garou-g/kicad-library/CHANGELOG.md

# Changelog
kicad-library changelog

## [Unreleased]
