garou-g/kicad-library/(commit log)

2019-11-25 Added Bus_PCI_Express_x1 connector
2019-12-11 USB-TYPE-C connector footprint
2020-01-17 Add n-mosfet SiSC06DN
2020-01-17 add p-mosfet SiSH101DN
2020-01-19 add TE_640456 connectors
2020-01-20 Added interactive bom plugin link to README
2020-01-24 Added TE_640456 connectors 3D model
2020-01-24 Changed BQ24090DGQ and added it footprint Texas_S-PDSO-G10_EP2x3mm_ThermalVias
2020-02-20 Added footprints for bluetooth antenna and noname vibromotor
2020-03-05 LED 3737_OSRAM, SMD 3528 patterns
2020-03-22 Changed bluetooth antenna footprint
2020-06-03 Added radial cap footprint with custom silkscreen
2020-06-03 Added SOIC-8 exposed pad footprint with custom changes
2020-06-03 Fixed 3D model path and silk thickness on TE connectors
2020-07-01 add TE_640445-2 connector 3d and footprint
2020-07-02 Added LTST-C195TBJRKT dual led footprint
2020-07-28 Fixed problem with 3d models with TE 64045x connectors
2020-07-28 Added custom JST PHD B14(6)B-PHDSS connectors with 3d models
2021-01-22 Added microSIM_A02608, BGA123L4 and other elements and footprints
2021-03-04 Added PBD-12 board edge connector footprint
2021-03-04 Added custom LGA-16 footprint with enlarged pads
2021-03-04 Added magnetic audio transducer buzzer CMT-0502-75-SMT-TR footprint and 3d
2021-03-10 Added LTE antenna W3796
2021-10-15 Added: - AS5510-DSOT magnetic sensor - DAC7571IDBV 12-bit I2C DAC - IRS-A200ST01 and IRS-B210ST01-R1 PIR sensors - LP5018 and LP5024 I2C LED drivers and others
2021-10-15 Fixed footprint name of Molex Pico-SPOX connector
2022-01-25 Updated lib to new Kicad 6 format
2022-06-01 Added symbol ADC124S101
    Added symbol ADC124S101CIMM 12-bit 4-channel ADC
2022-07-08 Updated LGA-12 footprint and added 3d model
